Inventoteca/Maquina_Garra/README.md

# Maquina_Garra
Repo para documentar el proyecto del sistema de seguridad para la máquina de la garra, ante inclinaciones se bloquee y sólo al recibir un pulso entonces se abra.
