Inventoteca/Maquina_Garra/Circuito Máquina Garra Peluches.png

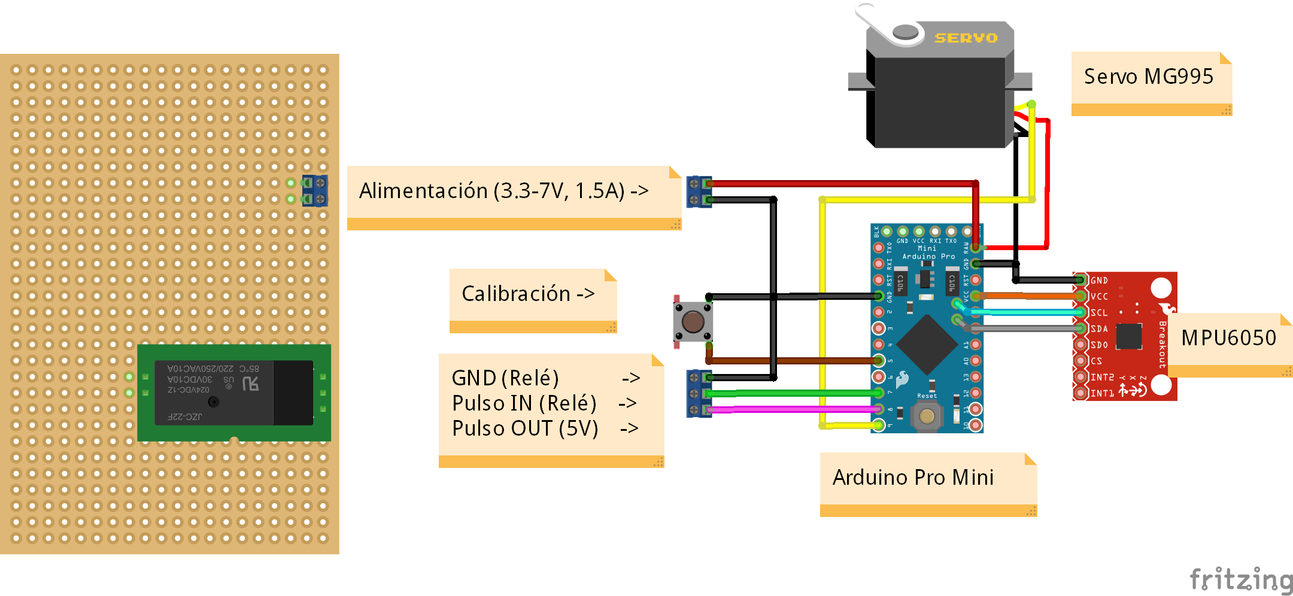
Circuito Máquina Garra Peluches.png
