Inventoteca/Maquina_Garra/Diseños/Circuito maquina garra peluches.dxf

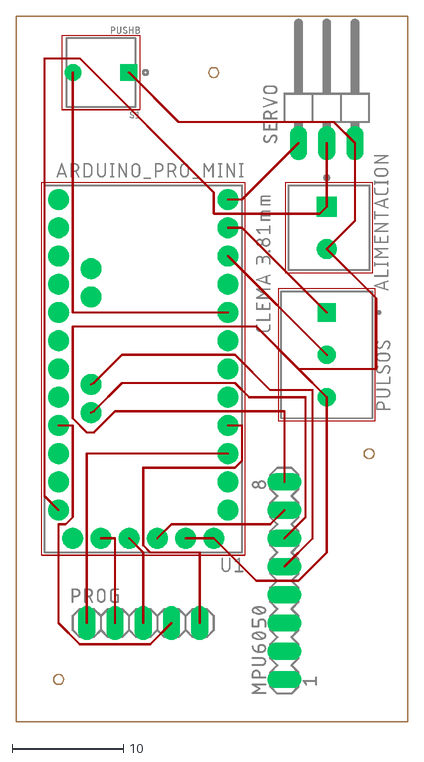
[picture p9: CAD file, 2021-10-20]
Diseños/Circuito maquina garra peluches.dxf
35.2 x 63.5
