Inventoteca/Maquina_Garra/Diseños/calzador agujeros servo.SLDPRT

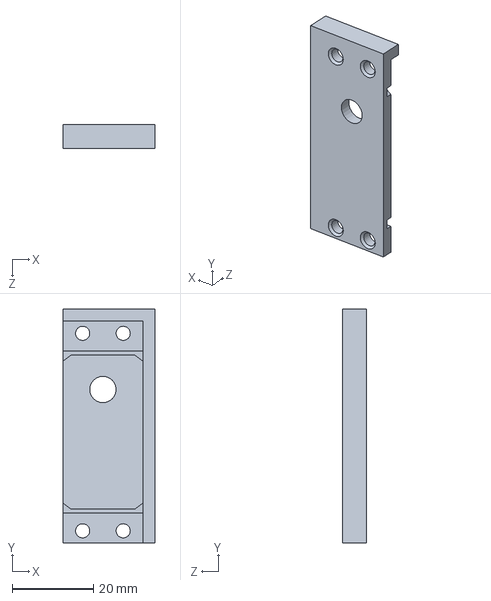
[picture p10: CAD file, 2021-10-20]
Diseños/calzador agujeros servo.SLDPRT
22.7 x 57.7 x 6.00 mm
