Inventoteca/Maquina_Garra/(list of files, cad)

Other CAD files:
Diseños/calzador agujeros servo.STL
