Inventoteca/Maquina_Garra/(commit log)

2021-10-13 cambio a LSM9DS1
    Se cambió a LSM9DS1 temporalmente para conseguir otro MPU
2021-10-16 MPU
    se regresó a MPU y añadió una función de calibración pero no funcionó
2021-10-18 Limpieza de código
2021-10-19 Servo y pulsos
    Se envía el documento correcto con las funciones designadas a controlar el servo y los pulsos de comunicación
    [codigo.ino]
2021-10-19 Implementación de función de calibración
    primer intento de implementar una función de calibración
2021-10-20 calzador servo
    [calzador agujeros servo.SLDPRT, calzador agujeros servo.STL]
2021-10-20 Función de calibración
    Se implementó la función de calibración en el código y se ajustaron valores de taolerancias
2021-10-20 Código casi funcional
    problemas con los detach
    [codigo.ino]
2021-10-20 Diseño PCB en Eagle y esquemático
    [Circuito maquina garra peluches.brd, Circuito maquina garra peluches.dxf, Circuito maquina garra peluches.sch]
2021-10-21 comentar el detach
2021-10-21 código comentado
    Se comentó el código para que se entienda mejor
2021-10-21 Código con guardado de calibración en EEPROM
2021-10-22 versión 2 circuito
2021-10-22 version2 circuito
2021-10-22 corrección circuito v2
2021-10-24 avances documentación
    [Circuito maquina garra peluches.brd, Circuito maquina garra peluches.sch]
2021-10-24 código completo
    Código cargado en la placa entregada al cliente
